adrianmarple/orbitron/creation/pcb/strip start/strip start.kicad_pcb

## KiCad design creation/pcb/strip start/strip start.kicad_pcb (2026-04-30)

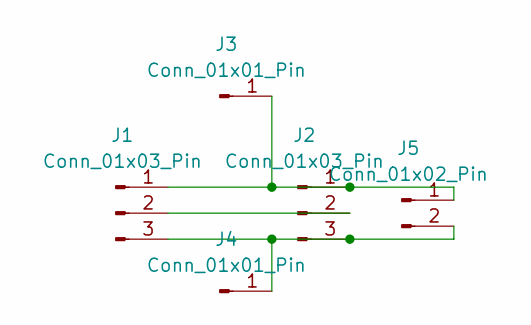
[picture p1: schematic strip start.kicad_sch]

Parts:
J1, J2: Conn_01x03_Pin; SolderWirePad_1x01_SMD_1x2mm
J3, J4: Conn_01x01_Pin; SolderWirePad_1x01_SMD_1x2mm
J5: Conn_01x02_Pin; SolderWirePad_1x01_SMD_1x2mm

Connections:
unnamed: J1.1, J2.1, J3.1, J5.1
unnamed: J1.2, J2.2
unnamed: J1.3, J2.3, J4.1, J5.2

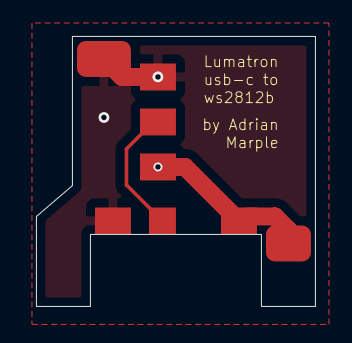
[picture p2: board strip start.kicad_pcb from above]

Board: 2 copper layers, 15.5 x 15.0 mm, 5 parts (0 on the bottom side), 3 nets.
